epatel/monotronics-legacy/pics/ds2762a.jpg

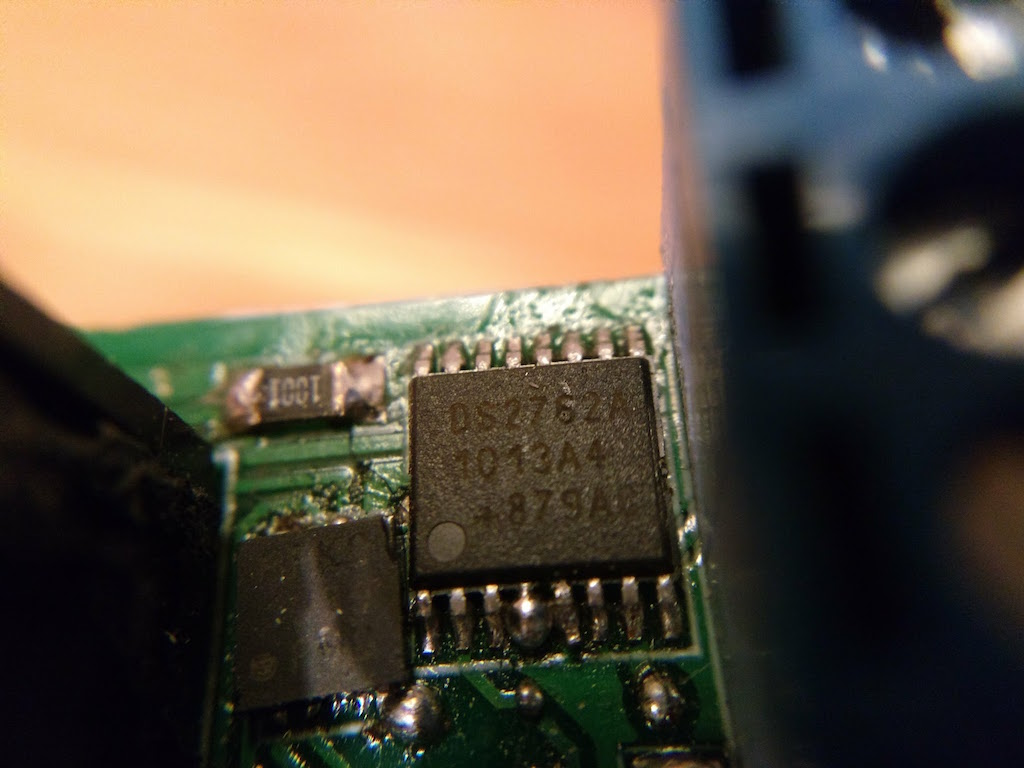
pics/ds2762a.jpg
