epatel/monotronics-legacy/pics/pogo-icsp.jpg

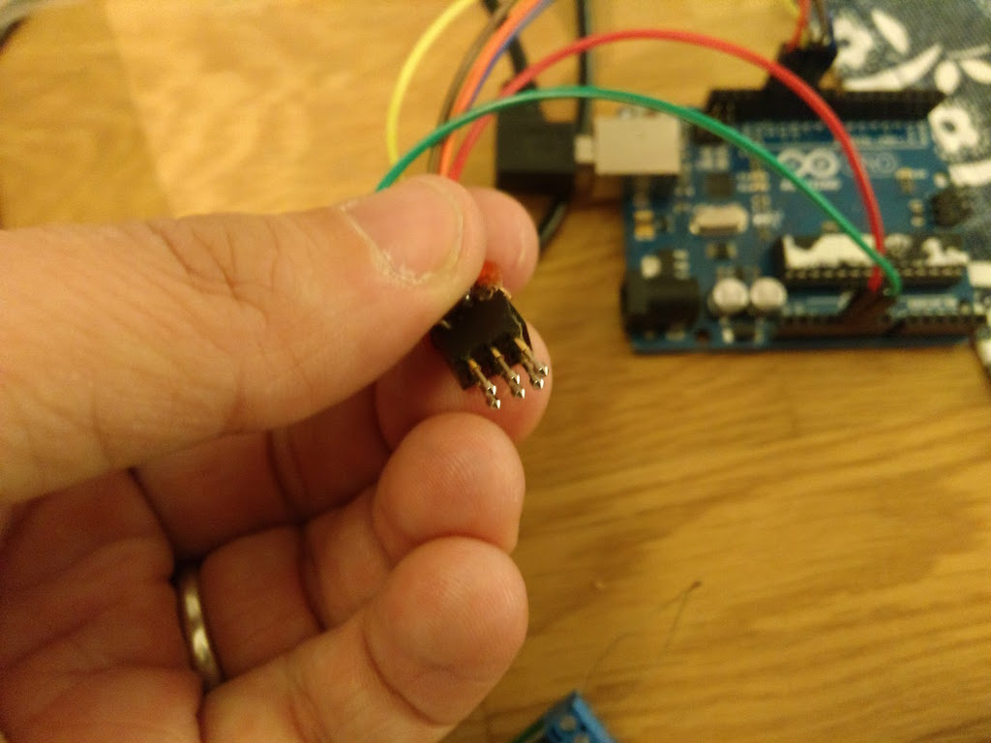
pics/pogo-icsp.jpg
