epatel/monotronics-legacy/README.md

# monotronics-legacy

Collecting some old info for the Monotronics card.

ITripMAX = VREF / ( 8 × RS)

RS = R250 = 0.25 ohm

<pre>
4V => 2.0A
3V => 1.5A
2V => 1.0A
1V => 0.5A
</pre>
