epatel/monotronics-legacy/pics/a3982slbt.jpg

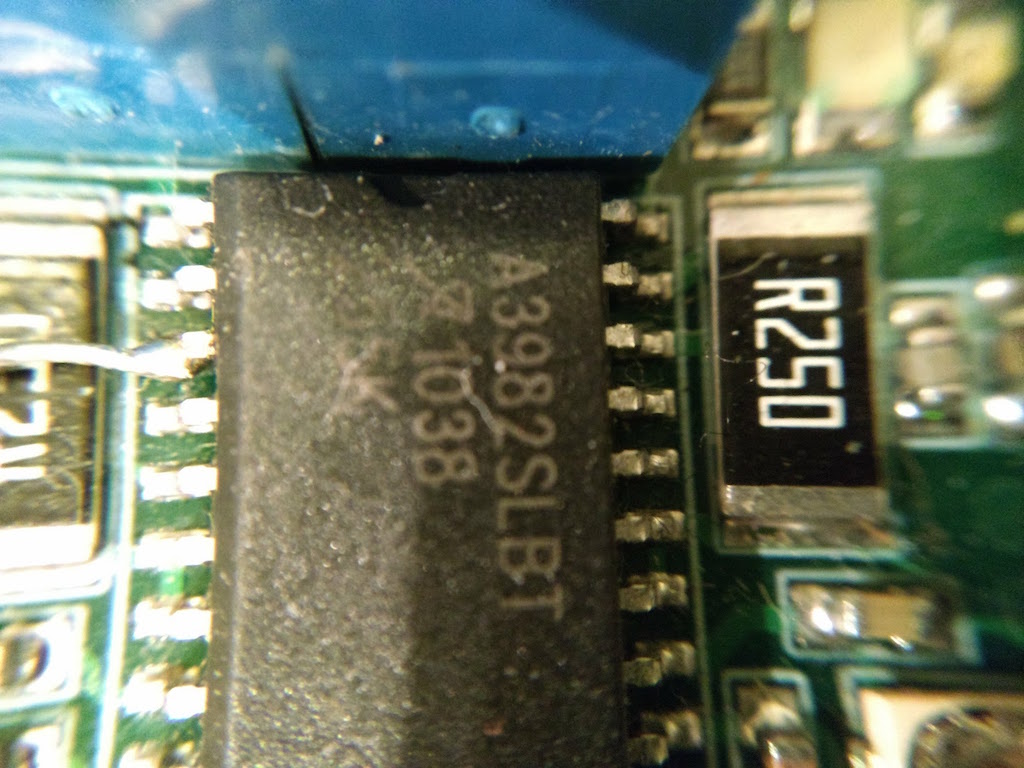
pics/a3982slbt.jpg
