epatel/monotronics-legacy/pics/atmel-mega644.jpg

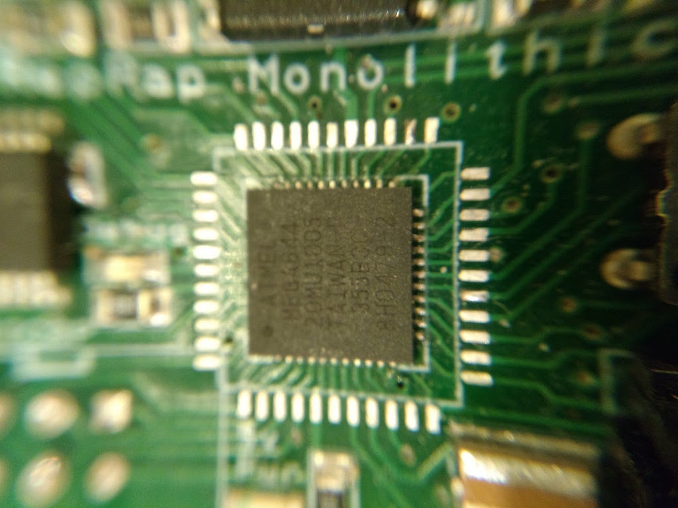
pics/atmel-mega644.jpg
