epatel/monotronics-legacy/pics/main+tipmanager.jpg

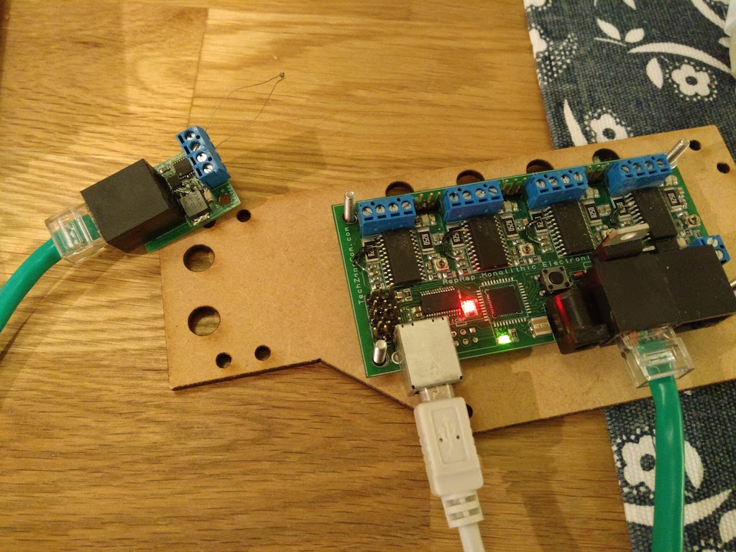
pics/main+tipmanager.jpg
