epatel/monotronics-legacy/pins/main-pcb/BottomSolderMask.pdf

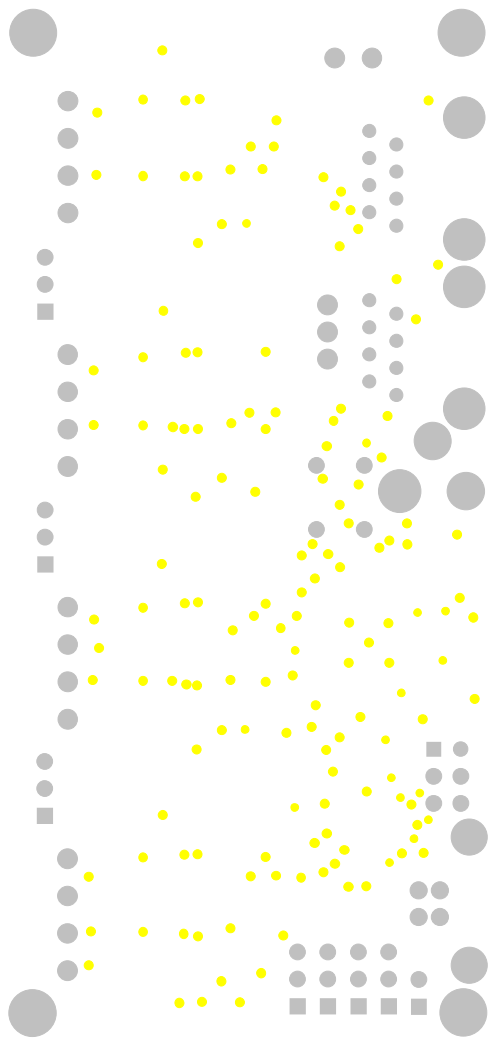
[picture p14: page 1]
