epatel/monotronics-legacy/pins/main-pcb/TopSolderMask.pdf

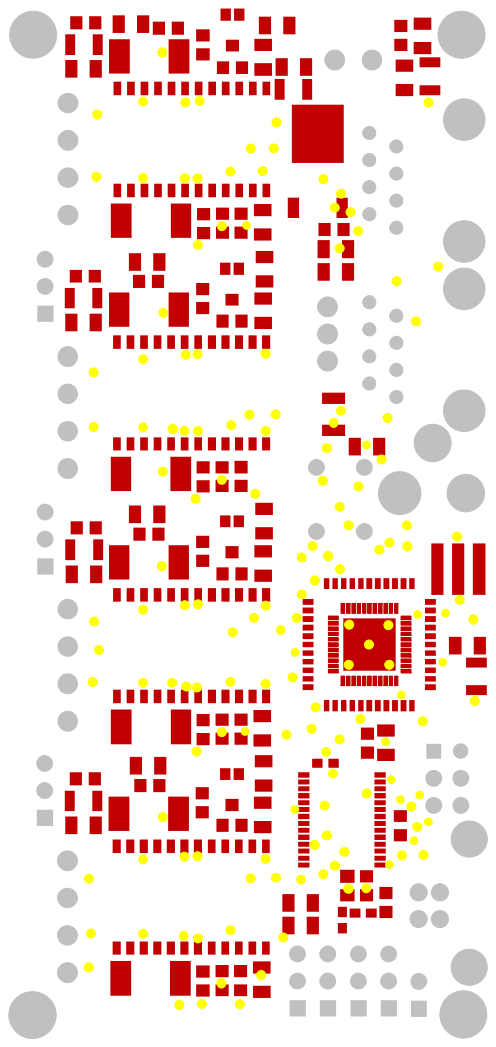
[picture p15: page 1]
