epatel/monotronics-legacy/pins/tipmanager-pcb/BottomSolderMask.pdf

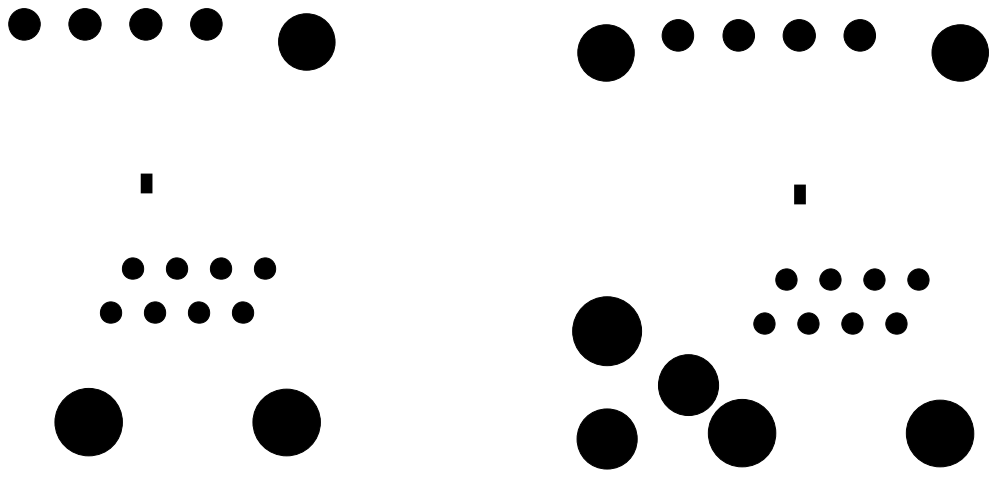
[picture p16: page 1]
