epatel/monotronics-legacy/pins/tipmanager-pcb/TopSolderMask.pdf

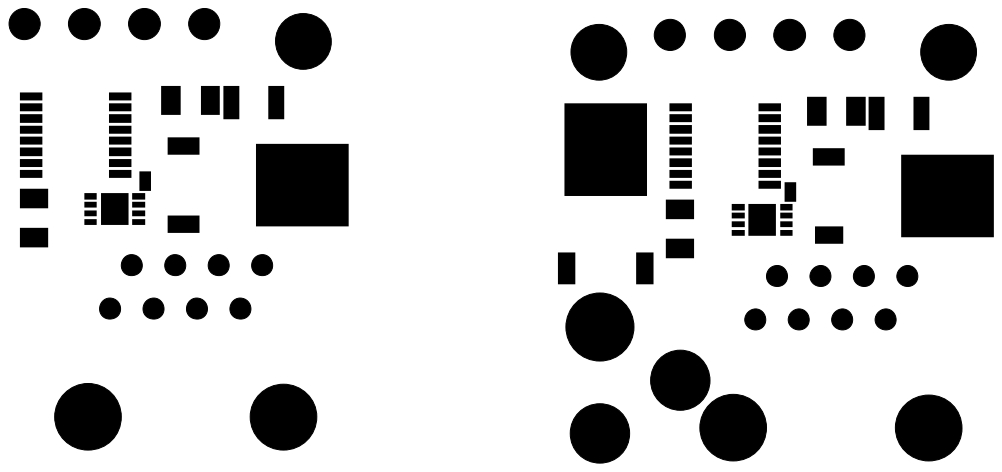
[picture p17: page 1]
