epatel/monotronics-legacy/pins/main-pcb/BottomCopper.pdf

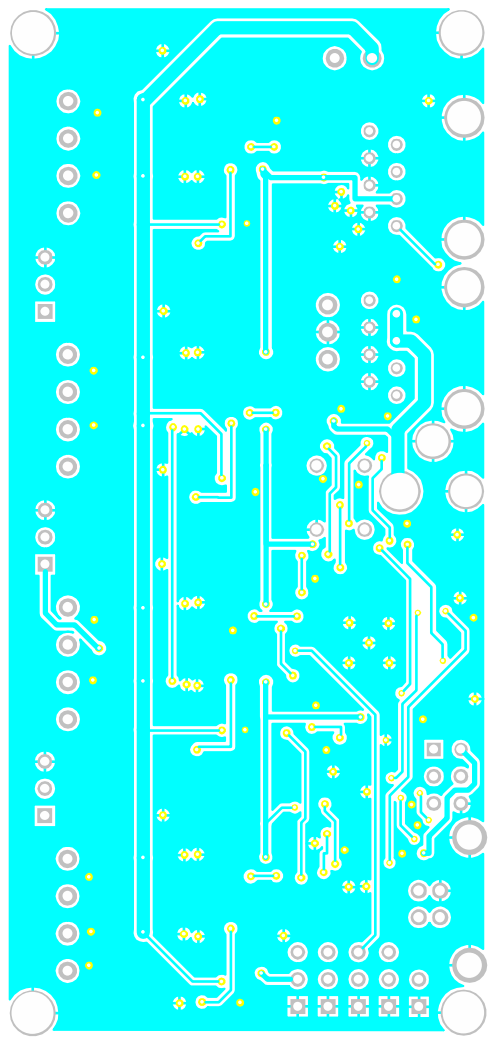
[picture p18: page 1]
