epatel/monotronics-legacy/pins/main-pcb/Documentation1.pdf

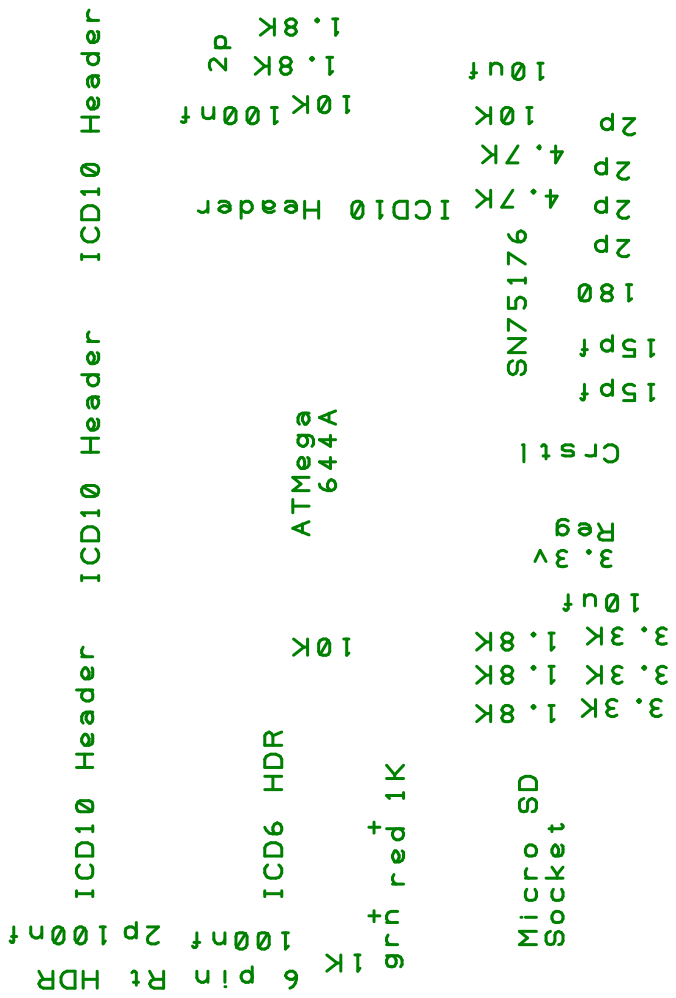
[picture p19: page 1]
