epatel/monotronics-legacy/pins/main-pcb/TopCopper.pdf

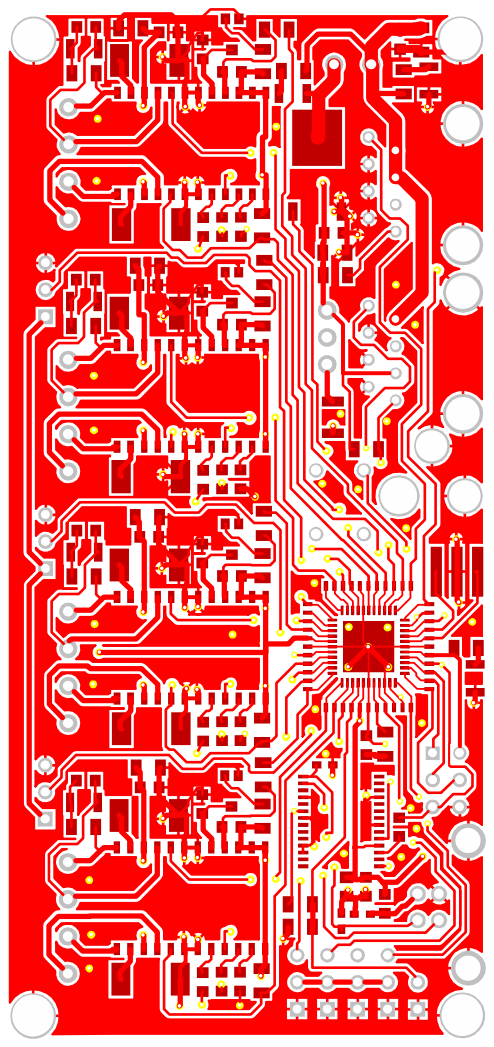
[picture p20: page 1]
