epatel/monotronics-legacy/pins/main-pcb/TopSilkScreen.pdf

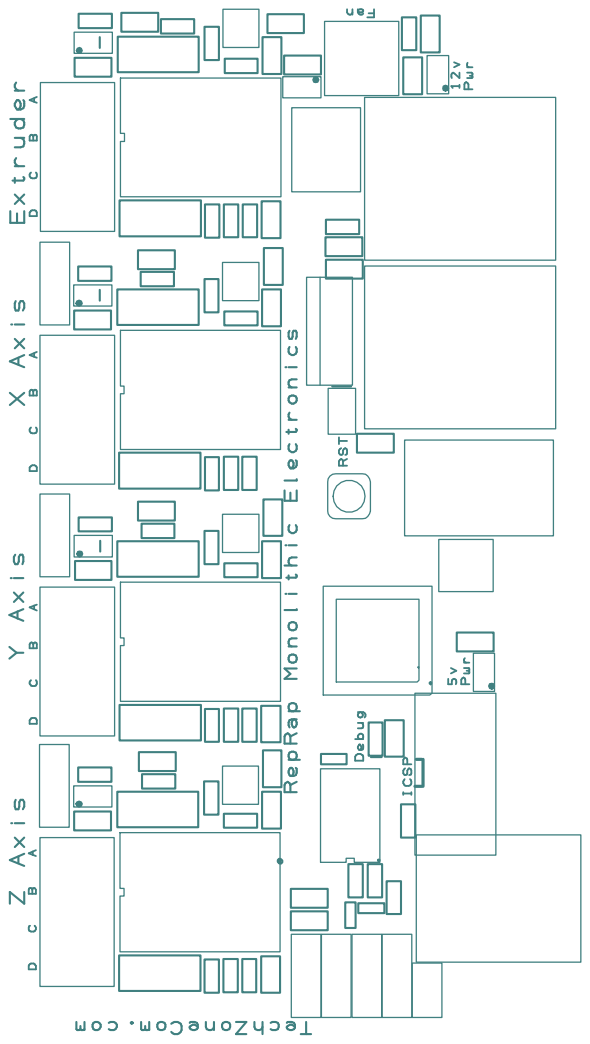
[picture p21: page 1]
