epatel/monotronics-legacy/pins/tipmanager-pcb/BottomCopper.pdf

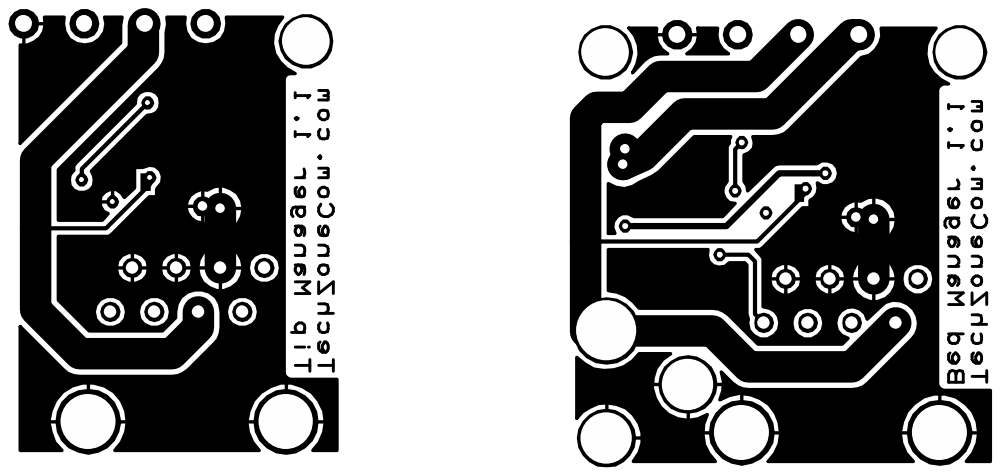
[picture p22: page 1]
