epatel/monotronics-legacy/pins/tipmanager-pcb/TopCopper.pdf

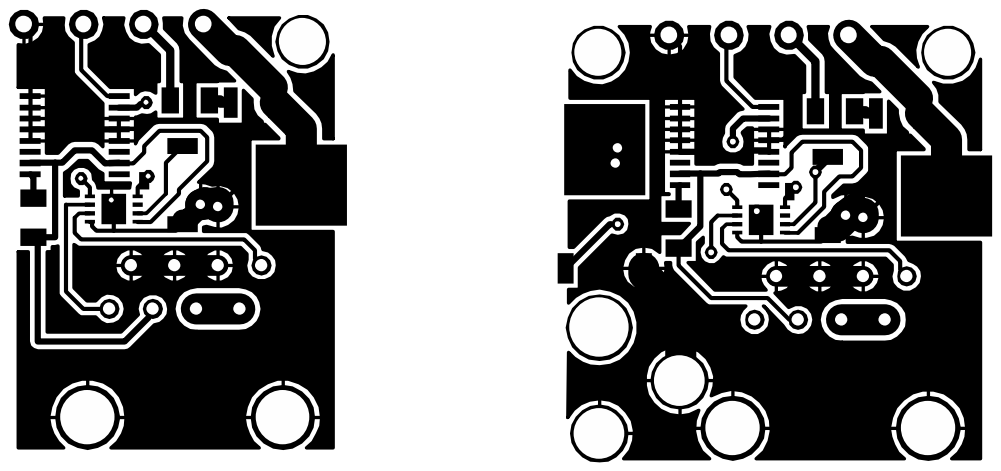
[picture p23: page 1]
