epatel/monotronics-legacy/(commit log)

2016-12-07 Inital commit
    [configuration.h]
2016-12-08 Added a couple of pics
